wulffern/rey_pll_sky130a/media/rey_pll_top_floorplan.png

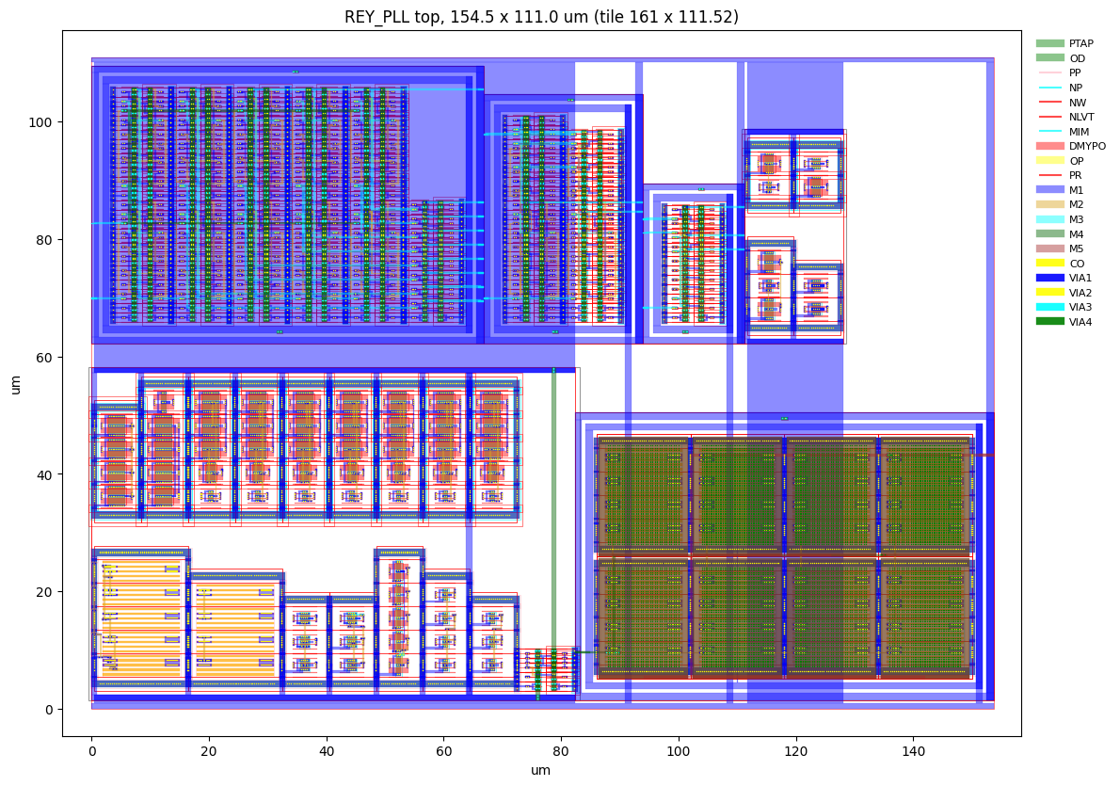
media/rey_pll_top_floorplan.png
