wulffern/rey_pll_sky130a/design/REY_PLL_SKY130A/REY_PLL_CP.md

Charge pump. The oscillator slows down as VCTRL rises, so UP sinks current
from VCTRL and DN sources it. The current is mirrored from the
oscillator's bias (VBP), 1.1 to 2.8 uA over the trim codes. The three
devices on the right park VCTRL at VDD_1V8 or VSS for power down and the
open loop modes, and pull the big capacitor down at power up (KICK).
