wulffern/rey_pll_sky130a/design/REY_PLL_SKY130A/REY_PLL_CTRL.md

Power up, the kick pulse and the two open loop modes. OLH parks VCTRL at
VDD_1V8, the oscillator's slowest, and OLL at VSS, its fastest: with the
divider taps on the pins that gives the oscillator's range at a trim code
without the loop.
