wulffern/rey_pll_sky130a/design/REY_PLL_SKY130A/REY_PLL_DIVN.md

Ripple divider, six flops. The fourth flop's output, CK/16, is the
feedback to the phase detector. CK/8, CK/16, CK/32 and CK/64 are buffered
to the pins, so the pins do not load the chain. Drawn as the three columns
of the layout.
