wulffern/rey_pll_sky130a/design/REY_PLL_SKY130A/REY_PLL_LPF.md

Loop filter, referenced to VDD_1V8 like the oscillator's control device.
Eight REYPLL_RCU cells: their 32 resistors in series are R (490 kOhm)
from VCTRL to VLPFZ, seven of the capacitors are C1 on VLPFZ and one is C2
on VCTRL.
