wulffern/rey_pll_sky130a/design/REY_PLL_SKY130A/REY_PLL_ROSC.md

Current starved ring oscillator: the bias, seven stages in a ring and the
output buffer. The trim code sets the bias current and with it the
frequency range; VCTRL moves the frequency inside the range, down as
VCTRL rises. Generated by `py/gen_rosc.py`.
