wulffern/rey_pll_sky130a/design/REY_PLL_SKY130A/REY_PLL_ROSC_BIAS.md

The bias of the ring, a current I = Vgs(MN1)/R. It falls with temperature
the way the ring's swing does, so the frequency at a trim code holds over
temperature. R is a ladder, 38.5 kOhm with three sections that TRIM0 to
TRIM2 short. The start-up circuit pulls VBP down while VG is low.
