wulffern/rey_pll_sky130a/design/REY_PLL_SKY130A/REY_PLL_ROSC_STAGE.md

One stage of the ring: an inverter on its own supply node VS, which two
mirror branches feed. The fixed branch sets the lowest frequency. The
other one goes through a device with its gate on VCTRL.
