wulffern/rey_pll_sky130a/design/REY_PLL_SKY130A/REYPLL_HRPPO8.md

Four resistors of 15.3 kOhm between two rows of dummies.
