wulffern/rey_pll_sky130a/design/REY_PLL_SKY130A/REYPLL_MIMU16.md

The MiM capacitor of the unit cell, 473 fF, 17.8 x 13 um between met3 and met4.
