wulffern/rey_pll_sky130a/design/REY_PLL_SKY130A/REYPLL_RCU.md

The unit cell of the loop filter: four 15.3 kOhm resistors (REYPLL_HRPPO8)
with a 473 fF MiM capacitor (REYPLL_MIMU16) stacked on top of them, 16 x
20.8 um. Compiled from `cic/lpf.json` with cicpy, which also writes this
schematic.
