wulffern/rey_pll_sky130a/design/REY_PLL_SKY130A/REYPLL_RES_36C2F0.md

One resistor of 15.3 kOhm: two high resistance poly segments, 0.4 um wide
and 8.16 um long, in series.
