wulffern/rey_pll_sky130a/design/REY_PLL_SKY130A/tt_um_rey_pll_wulffern.md

REY_PLL in one Tiny Tapeout tile: the core, an antenna diode on every
input, and a tie to ground through a metal resistor on every output the
PLL does not drive. Generated, layout and schematic, by `py/gen_tt_um.py`.
