wulffern/rey_pll_sky130a/media/rey_pll_how.png

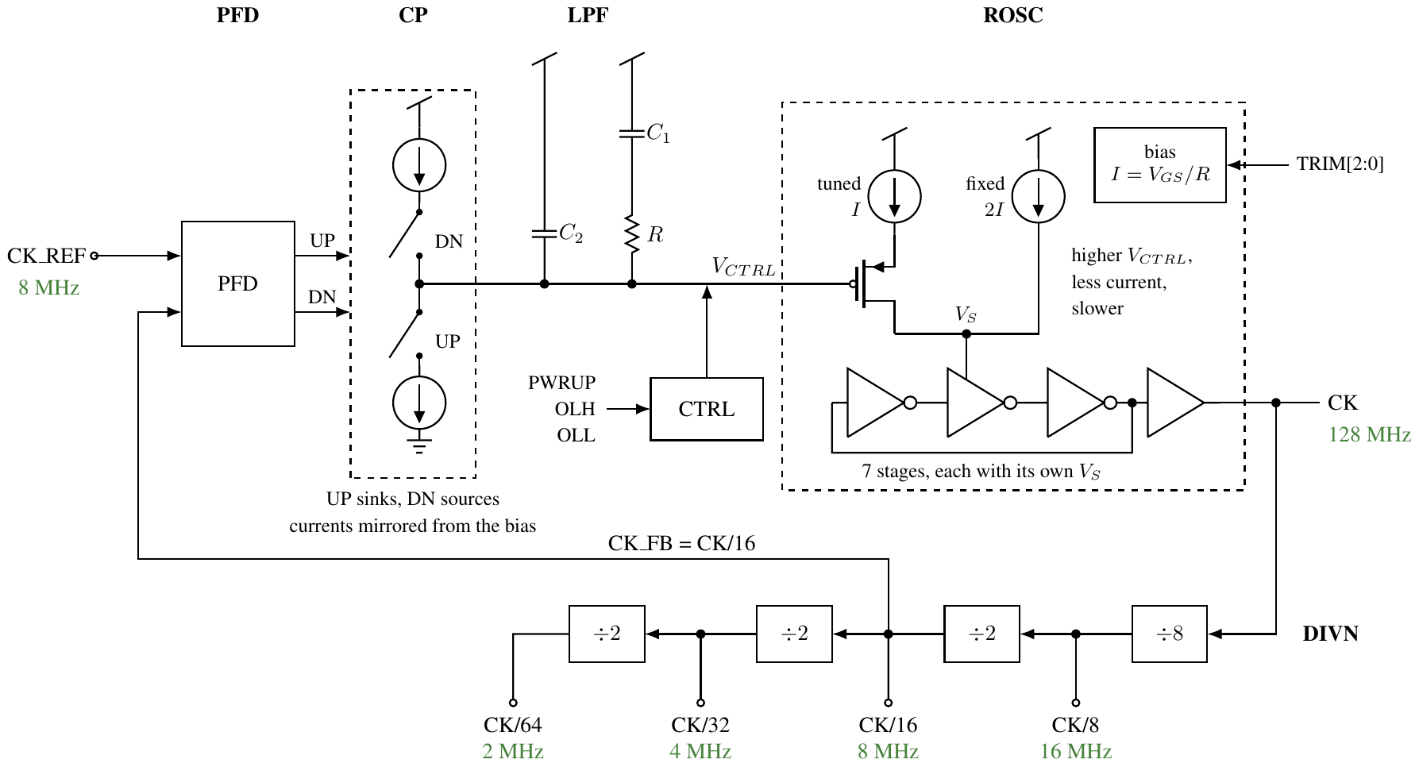
media/rey_pll_how.png
