wulffern/rey_pll_sky130a/(commit log)

2026-11-07 Made REY_PLL_SKY130A
    [REY_PLL.sch]
2026-11-08 Add REY_PLL_ROSC current starved ring oscillator and loop model
    - py/gen_rosc.py generates REY_PLL_ROSC.sch/.sym: 7 stage ring with
    1F2 inverters, PMOS supply per stage from a fixed mirror branch plus
    a VCTRL steered branch (f falls as VCTRL rises), constant-gm bias
    with a 3 bit RPPO/HRPPO trim resistor, IVX1/IVX4 output buffer
    - sim/REY_PLL_ROSC: TRIM x VCTRL sweep, frequency measured after
    settling; trim.py summarizes which codes reach the target per corner
    - py/pll.py designs the loop filter (C1, C2, R) for a crossover and
    phase margin, with area estimates against a Tiny Tapeout tile
    Claude-Session: https://claude.ai/code/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
    [REY_PLL_ROSC.sch]
2026-11-08 REY_PLL_ROSC: Vgs/R bias so the frequency holds over temperature
    With an ideal constant current the ring still runs 20-50 % faster hot
    than cold, its swing follows the thresholds. A threshold referenced
    bias, I = Vgs(MN1)/R, falls with temperature the same way, so f ~
    1/(R C): at VCTRL = 0 Ktt code 3 is 555/565/571 MHz at Tl/Tt/Th, and
    every process corner at Vt now has trim codes reaching 512 MHz at all
    three temperatures.
    - gen_rosc.py: BIAS=vt (default now via the regenerated schematic),
    R is the RPPO trim ladder (46k + 7.7k/15.4k/30.8k switched)
    - startup MS3 returns to VG instead of VSS; to VSS it latched the
    bias in a high current state (~1.4 GHz regardless of trim)
    - BIAS=ext / R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
    [REY_PLL_ROSC.sch, REY_PLL_ROSC_IEXT.sch]
2026-11-08 Document REY_PLL_ROSC; recentre trim, LVT follower, startup test
    - README: why, the oscillator schematic block by block, the loop
    filter procedure, how to run the simulations, results so far
    - info.yaml: author, tagline, docs list
    - gen_rosc.py: BIAS=vt is now the default in code (the previous
    commit only had it in the generated schematic); fixed R 46.2k ->
    38.5k to give the slow corner margin at the top trim code; MN2 is
    4 x LVT_NCH_2C5F0 so VX leaves the MPB mirror in saturation
    - tran.spi: measure VX and the startup node XST in every run
    - startup.spi: supply ramp of 10 us and 100 ns at codes 0 and 7
    Claude-Session: https://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
    [REY_PLL_ROSC.sch]
2026-11-08 Loop filter caps are MiM (CAPX1) over the HRPPO resistor
    pll.py now counts REYATR_CAPX1 units (51.2 fF in 8 x 8 um) and reports the
    footprint with the MiM bank on top of R; the smallest point is near
    Icp = 1.3 uA (C1 52 units, C2 4, R 567 kOhm, 20 % of a tile). The plan
    puts the bottom plate on VDD_1V8.
    Claude-Session: https://claude.ai/code/session_01LFsEEfu2Um15wXL3R6Kp8u
2026-11-08 Loop filter unit cell REYPLL_RCU: MiM on top of HRPPO8, compiled with cicpy
    cic/lpf.json defines two cells, compiled with `cd work && make cic`
    (cicpy compile against rey_atr's resistor patterns, prefix REYPLL_):
    - REYPLL_MIMU16: a 13 x 17.8 um MiM (473 fF, simulated tt) on the 16 x
    20.8 um HRPPO8 footprint, margins as in REYATR_CAPX1
    - REYPLL_RCU: a LayoutRotateCell, which places every instance at the
    origin, so the MiM sits on top of the four 15.3 kOhm resistors
    Both DRC clean and LVS "Circuits match uniquely". 1.4 fF/um2 of
    footprint against 0.8 for CAPX1. pll.py sizes the filter in RCU cells:
    at Icp = 1.6 uA it is 8 cells, 2662 um2, 15 % of a tile.
    README: results over all 45 corn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
    [REYPLL_HRPPO8.sch, REYPLL_MIMU16.sch, REYPLL_RCU.sch, REYPLL_RES_36C2F0.sch, REYPLL_RES_36CTAPBOT.sch, REYPLL_RES_36CTAPTOP.sch]
2026-11-08 REY_PLL_ROSC: a schematic a human can read
    gen_rosc.py now draws the ring stage once, as bus instances with the
    ring nets listed (xip[6:0], gates N5..N0,N6), wires for the local nets
    (NC, VS, the inverter output, the diode tie, the resistor chain), labels
    only for supplies and the nets that cross blocks, and a title and a
    one-line explanation per block: bias, startup, trim resistor, ring,
    output buffer. Instance names are lowercase for cicpy.
    Same circuit: typical is unchanged (273-507 MHz at code 0, 442-951 MHz
    at code 7). A discrete 2C1F2 first buffer was tried and slowed the ring
    by 20 % (it loads the last node), so the output stays REYTR_IVX1 then
    IVX4. The constant-gm and resistor-only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
    [REY_PLL_ROSC.sch]
2026-11-08 REY_PLL_ROSC layout: sidecar and placement (work in progress)
    design/REY_PLL_SKY130A/REY_PLL_ROSC.py places the oscillator as two
    rows, every column five devices or fewer: 82.4 x 56.7 um, 26 % of a
    Tiny Tapeout tile.
    top (n-well): p_diode p_mirb p_st0 .. p_st6
    bottom: r_trim r_fix n_sw n_su n_bias n_ring_a n_ring_b dig
    The trim resistor is now REYATR_RES_36C2F0 units (15.3 kOhm): the
    composite RPPO cells lost their bulk pin when cicpy split the cell
    into columns. Typical frequency is unchanged within 0.3 %.
    Not DRC clean yet: the routes inside the columns are still the maze
    search's, and where it draws a net as two legs it puts two via pads
    0.2 um apart (616 errors at the top,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
    [REY_PLL_ROSC.sch, REY_PLL_ROSC_DIG.sch, REY_PLL_ROSC_N_BIAS.sch, REY_PLL_ROSC_N_RING_A.sch, REY_PLL_ROSC_N_RING_B.sch, REY_PLL_ROSC_N_SU.sch, REY_PLL_ROSC_N_SW.sch, REY_PLL_ROSC_P_DIODE.sch]
2026-11-08 REY_PLL: PFD, charge pump, loop filter, divider and control ported from sun_pll; locks at 512 MHz
    Schematics generated by py/gen_pll.py with cicpy.eda.schgen:
    - REY_PLL_CTRL: power up, sun_pll's KICK pulse, and open loop test modes
    (OLH parks VCTRL at VDD_1V8, OLL at VSS) for the per-die trim
    - REY_PLL_PFD: tri-state PFD on DFRNQNX1. That flop clocks on
    NAND(CK, RN), so released from reset with CK high it sets again; each
    flop's reset is now held until its own clock is low (HU/HD latches).
    Without that the loop locked with a 55 ns phase offset and 210 mV of
    VCTRL ripple
    - REY_PLL_CP: Icp from the oscillator's VBP (one LVT_PCH_4C5F0), UP
    sinks and DN sources (negative Kvco); VCTR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
    [REY_PLL.sch, REY_PLL_CP.sch, REY_PLL_CTRL.sch, REY_PLL_DIVN.sch, REY_PLL_LPF.sch, REY_PLL_PFD.sch, REY_PLL_ROSC.sch, REY_PLL_ROSC_DIG.sch]
2026-11-08 REY_PLL: first top level placement in the tile, all blocks laid out
    - py/gen_pll.py is the single source for the standard cell blocks
    (CTRL, PFD, DIVN, LPF): one definition writes the xschem schematic,
    drawn column by column with the layout's instance names (XA0, XA1,
    ...), and cic/pll.spi, which cicpy compiles into the layout. The
    xschem netlist and pll.spi agree instance by instance
    - cic/pll.json: CTRL, DIVN (six columns, 66.8 x 47.4 um) and LPF (four
    columns of two RCU, 71.4 x 49.0 um) as ciccreator cells, next to the
    PFD; CTRL publishes OLH/OLL explicitly (their only pins are gate
    inputs named B, which the port search takes for bulks)
    - REY_PLL_CP: sidecar, two rows of two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
    [REY_PLL_BLK_CP.sch, REY_PLL_BLK_CTRL.sch, REY_PLL_BLK_DIVN.sch, REY_PLL_BLK_LPF.sch, REY_PLL_BLK_PFD.sch, REY_PLL_BLK_ROSC.sch, REY_PLL_CP_N_CP.sch, REY_PLL_CP_N_PARK.sch]
2026-11-08 REY_PLL_CTRL layout DRC and LVS clean
    Every internal net is now a hop between neighbouring cells: a second
    inverter (PWRUP_NB) drives the NORs locally, so no trunk runs the
    length of the column. Hops alternate M2/M3 so no two on one layer share
    a row; PWRUP_1V8 reaches both inverters on an M4 trunk left of the pins
    (track-2); its edge port reuses the route's via stack (nostartcut).
    The supply straps had been drawn 0 wide (routeWidth=wide_width, a rule
    this technology lacks), which left VSS/VDD_1V8 disconnected.
    DRC 0, LVS: Circuits match uniquely. The routing rules for rey_tr
    columns are written into cic/pll.json.
    Claude-Session: http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
    [REY_PLL_CTRL.sch]
2026-11-08 REY_PLL_PFD layout DRC and LVS clean
    One column with every non-neighbour net on its own M5 ring: inputs
    connect left on M4, outputs right on M3, the flops' D right on M4, hops
    put their trunk left of the input pins. The flops' RN pin is reached
    from M2, where the flop already has its own via; DN_N now comes from an
    inverter on DN, since an outside stack cannot share the via on QN.
    Connection nets are anchored regexes (DN matched DN_N).
    Circuit: the flops' D is PWRUP_1V8 (high whenever the PLL runs), so no
    tie cell; DN_N = not DN through XA11.
    DRC 0, LVS: Circuits match uniquely. CTRL still clean.
    Claude-Session: https://claude.ai/cod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
    [REY_PLL_PFD.sch]
2026-11-08 REY_PLL_DIVN layout DRC and LVS clean
    Five columns of two stages, every other column mirrored (alternateGroup)
    so n-wells face n-wells. Per stage: the flop with its tap buffer over it,
    so Q reaches the buffer and the next flop's CK in one M2 hop; D = QN on
    M3 from the flop's own via on QN, out right of the flop's internal M3;
    the column crossings run on M5 from the stage buffer's input (a dummy
    inverter for stage 1, which has no tap); one supply strap per column.
    Circuit: the divider has no reset any more (RN tied to the flop's own
    VDD strip by an M5 jumper). A ripple divider runs from any state and the
    PFD does not care about its phase; PWRUP_1V8 to ten RN pins could not be
    routed without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
    [REY_PLL.sch, REY_PLL_DIVN.sch]
2026-11-08 REY_PLL_LPF layout DRC and LVS clean
    Routes generated from the netlist (py/gen_pll.py, lpf_layout): the
    resistor chain on M2 inside a column and M3 between columns, all under
    the MiMs; VCTRL and VLPFZ leave sideways on M3 and climb to M5 only on
    their bars outside the cells, as directed routes to the named rails (a
    connection by net took the resistor end and the plate alike and dropped
    an M1-M5 stack inside a MiM); the VLPFZ top plates join along each row's
    bottom margin on M5; a VDD strap per column for the bottom plates; the
    supply rings on M2, since on li they came too close to the RCUs' own li.
    Circuit: C2 (the VCTRL MiM) is now the first cell, so VCTRL's resistor
    end and plate are both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
    [REY_PLL_LPF.sch]
2026-11-08 REY_PLL_CP layout DRC and LVS clean
    Channel routes between the two rows for the nets that cross them
    (VCTRL, VBN, VBP), a 6 um channel; VCTRL drops into the source stack
    from the right, since on the left it ran into the stack's own VPS wire.
    DRC 0, LVS Circuits match uniquely.
    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
2026-11-09 REY_PLL_ROSC_STAGE: one ring stage as its own cell, DRC and LVS clean
    The oscillator is now built bottom up, as lelo_temp is: the ring stage
    (starved inverter, its mirrors and the VCTRL device) is its own
    schematic, generated by py/gen_rosc.py, and REY_PLL_ROSC instantiates
    it as xstg[6:0]. Its layout is finished on its own: the PMOS column
    over the NMOS, A and Y across the channel, VS and NC as declared paths
    anchored to the pins (the search put VS's via 0.12 um from the gate
    contact, and NC on top of VS).
    DRC 0, LVS Circuits match uniquely. 9.0 x 40.6 um.
    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
    [REY_PLL_ROSC.sch, REY_PLL_ROSC_STAGE.sch, REY_PLL_ROSC_STAGE_N_ST.sch, REY_PLL_ROSC_STAGE_P_ST.sch]
2026-11-09 REY_PLL_ROSC_BIAS: the Vgs/R bias as its own cell (work in progress)
    The oscillator is now xbias + xstg[6:0] + the output buffer. The bias
    cell's stacks come out of the router clean except N_SU (8) and an
    internal VG/VX short in N_BIAS; between the stacks the channel drops
    collide where one net's pin lies under another's: with lanes per net
    VBP/VG/VX/XST are separated, but the trim stack has room for one lane
    past RT1's own via and needs two. Not DRC/LVS clean yet.
    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
    [REY_PLL_ROSC.sch, REY_PLL_ROSC_BIAS.sch, REY_PLL_ROSC_BIAS_N_BIAS.sch, REY_PLL_ROSC_BIAS_N_SU.sch, REY_PLL_ROSC_BIAS_N_SW.sch, REY_PLL_ROSC_BIAS_P_DIODE.sch, REY_PLL_ROSC_BIAS_P_MIRB.sch, REY_PLL_ROSC_BIAS_R_FIX.sch]
2026-11-09 REY_PLL_ROSC_BIAS layout DRC and LVS clean
    The bias as its own cell, routed group by group: each stack clean on its
    own first, then the channels between them.
    - n_bias and n_su: a device's drain lies right under its gate, so the
    three nets that cross there each take a layer and a lane, declared as
    paths anchored to the pins (the search shorted VG to VX)
    - r_trim and r_fix: both pins of every resistor unit sit at the same x,
    and each net spans another's pin row; two M2 lanes alternate
    - the channel: tracks two lanes apart (a rail via's pad is taller than
    the bar); drops that climb past a stack's lanes or other tracks' bars
    go up on M4; VG's drop in n_su lands on the stack's own VG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
    [REY_PLL_ROSC_STAGE.sch]
2026-11-09 REY_PLL_ROSC from finished blocks, DRC and LVS clean
    The oscillator now places REY_PLL_ROSC_BIAS, the buffer and seven
    REY_PLL_ROSC_STAGE cells, interleaved (0 6 1 5 2 4 3) so no ring hop
    spans more than two stages, and routes only between them: ring hops
    M4 down to M5 lanes under the ports, VBP and VCTRL on M5 at the pins'
    height, VBP in from the bias's bar. All anchored to pins.
    mag uses a local tech (cic/sky130A.tech: shared rules plus met3/met4
    minimum area) so the stacks' middle pads meet met3.6.
    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
    [REY_PLL_ROSC_BLK_BIAS.sch, REY_PLL_ROSC_BLK_DIG.sch, REY_PLL_ROSC_BLK_STG0.sch, REY_PLL_ROSC_BLK_STG1.sch, REY_PLL_ROSC_BLK_STG2.sch, REY_PLL_ROSC_BLK_STG3.sch, REY_PLL_ROSC_BLK_STG4.sch, REY_PLL_ROSC_BLK_STG5.sch]
2026-11-09 REY_PLL_ROSC_BIAS split vertically: one row, 75 x 36.8 um
    The pmos columns sit beside the nmos and resistor columns past a well
    gap instead of in a row over them, and the crossing nets run in a
    channel over the row. The bias drops from 57 x 61.6 to 75 x 36.8 um,
    under a stage's height, and the oscillator from 132 x 65 to
    150.8 x 43.7 um. DRC and LVS clean, bias and oscillator.
    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
2026-11-10 REY_PLL top assembled, DRC and LVS clean
    The blocks publish the ports the top reaches on an edge (CP: control
    in on top, loop filter nets out below; ROSC: VBP, VCTRL, CK on top;
    DIVN: CK_FB on top) and the top routes only between them, every path
    anchored to a pin, a channel track or a ring: VCTRL, VLPFZ, VBP and CK
    in the channel between the rows, UP/DN_N and KICK/VLO/VHI_N over CTRL,
    PWRUP_1V8 under the PFD's rails, CK_FB over the PFD onto its ring.
    Supplies: two rings round the whole, every block strapped to them on
    M4. A gap before CP keeps its guard off CTRL's VDD ring. The
    compiled cells are regenerated from cic/ (pll.json gains DIVN's CK_FB
    edge port); the flat oscillator's old column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
    [REY_PLL_BLK_DIVN.sch]
2026-11-10 REY_PLL_PFD as two mirrored columns: 27.2 x 42.7 um
    The PFD was one column of cells inside ten M5 signal rings, 37.7 x 95.8
    um. It is now an UP half and a DN half side by side with 21 directed
    routes written by pfd_layout in gen_pll.py: 1160 um2 against 3600. DRC
    clean, LVS matches. Pins A and B are swapped on two symmetric gates so
    the nets that cross between the columns are straight bars.
    The top is not rebuilt: REY_PLL.py still routes to the old PFD's rings.
    plans/HANDOFF.md has the floorplan arithmetic, which shows the blocks do
    not fit one tile by rearranging alone.
    Claude-Session: https://claude.ai/code/session_01LFsEEfu2Um15wXL3R6Kp8u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
    [REY_PLL_PFD.sch]
2026-11-11 Top re-floorplanned to fit one Tiny Tapeout tile
    The core is 156.96 x 106.94 um (was 209 x 155), for a 161 x 111.52 um
    tile. DRC (magic and klayout) and LVS clean.
    - Top row is PFD | CTRL | CP | DIVN | LPF over the oscillator. The
    blocks carry no rings of their own; their rails are strapped to the
    top's two rings on M4.
    - CTRL, PFD, DIVN and LPF publish their ports on an edge and their
    supplies as rails along the top.
    - The divider is six flops with four taps, CK/8 to CK/64. Ten flops and
    eight taps made the top row 162.8 um wide and could not fit; taps
    CK/128 to CK/1024 are gone, and uo_out[4..7] with them.
    - M5 risers carry the tile's pins (CK_REF, PWRUP_1V8, OLL, OLH, CKO0-3,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
    [REY_PLL.sch, REY_PLL_BLK_DIVN.sch, REY_PLL_DIVN.sch]
2026-11-11 Tiny Tapeout wrapper tt_um_rey_pll_wulffern, generated
    py/gen_tt_um.py writes the wrapper's layout and schematic from one set
    of tables, after lelo_temp's recipe: the port row from the tile's DEF,
    two met4 rails at the west edge, antenna diodes on the seven inputs in
    use, and the twenty outputs nothing drives (uio_oe, uio_out,
    uo_out[7:4]) tied low through a res_generic_m4 each.
    The core is mirrored in x so its risers stand in the order of the pads,
    and reaches them through five met3 tracks in the 3.58 um over it. Its
    rings are locali only, so each rail has a met1..met4 pad and a met1
    bridge to its ring's column.
    clk = CK_REF, ui_in[0] = PWRUP_1V8, ui_in[3:1] = TRIM, ui_in[4] = OLH,
    ui_in[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
    [tt_um_rey_pll_wulffern.sch]
2026-11-11 Wrap-up: docs as built, testbenches for both views, extracted core does not lock
    README, plans/LAYOUT.md and plans/HANDOFF.md describe the layout as
    built: the core at 156.96 x 106.94 um, the six flop divider with four
    taps, the generated Tiny Tapeout wrapper and its pins.
    The testbenches in sim/REY_PLL and sim/REY_PLL_ROSC reach inner nets
    through P_<net> aliases, so the same file runs on the schematic and on
    the flat extracted netlist. corners.sh takes the view as an argument.
    Finding: the schematic locks in the typical corner (CK 512.02 MHz,
    ripple 8.5 mV). The extracted core does not: CK 264.9 MHz with VCTRL
    at 0 V. The extracted oscillator reaches 211 to 371 MHz over the trim
    codes ag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
2026-11-11 Lock at 128 MHz: feedback from CK/16, layout clean again
    The extracted oscillator reaches 146 to 189 MHz in the slow corner, so
    the loop closes at N = 16 with the oscillator untouched. CK_FB now leaves
    the divider from a mirrored column, beside the CK/8 tap: its edge pin is
    one wire across (cicpy narrowpin) and the top steps the tap's riser a
    pitch and a half aside. Divider, top and wrapper are DRC and LVS clean,
    top and wrapper also in KLayout DRC, the wrapper in the antenna check.
    The extracted core locks at 128.0 MHz in typical and in Ktt and Kfs over
    temperature and supply; Kss, Kff and Ksf are still running. The loop
    filter is the N = 64 one and is not retuned.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
    [REY_PLL.sch, REY_PLL_DIVN.sch]
2026-11-12 Docs: every design schematic on the page, redrawn; all 21 corners lock
    Documentation:
    - info.yaml lists the 14 schematics of the design, top down, and each
    has a short design/REY_PLL_SKY130A/<cell>.md that the Schematics page
    puts over the drawing
    - sim/REY_PLL/README.md and sim/REY_PLL_ROSC/README.md for the
    Simulations page, with the tables written in (results/ is not in git)
    - README and plans/HANDOFF.md: the extracted core locks at 128 MHz in
    typical and all 20 corners (five processes, -40/125 C, 1.7/1.9 V, one
    trim code per process), VCTRL 0.56 to 1.53 V, ripple 8 to 13 mV. Not
    done: loop filter for N = 16, the trim sweep on the extracted
    oscillator
    Schematics, drawing on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
    [REYPLL_HRPPO8.sch, REYPLL_MIMU16.sch, REYPLL_RCU.sch, REYPLL_RES_36C2F0.sch, REY_PLL.sch, REY_PLL_BLK_LPF.sch, REY_PLL_CP.sch, REY_PLL_CP_N_PARK.sch]
2026-11-12 make lpe runs through: local netgen setup without series merging of res_high_po
    The LVS workflow failed in its LPE step, not in LVS: netgen segfaults
    (remove_group_tags, NULL open tag) comparing the flat extracted netlist
    with the hierarchical schematic, on the series/parallel merging of the
    oscillator bias ladder's poly resistors.
    work/Makefile points PDKPATH at cic/netgen for the lpe target; the setup
    there sources the PDK one and turns series merging off for
    sky130_fd_pr__res_high_po. REY_PLL, REY_PLL_ROSC and REY_PLL_DIVN
    extract and match uniquely. The shared tech is not touched.
    Claude-Session: https://claude.ai/code/session_01LFsEEfu2Um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
2026-11-13 README: a top level picture of how the loop works
    Drawn with cictikz, source in media/rey_pll_how.tex. The forward path is
    the VCTRL net from the charge pump to the gate of the oscillator's control
    device, the charge pump and the loop filter are drawn as circuits, and the
    divider's taps carry their frequencies at lock.
    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
